ElonFreeman/Jaeger_robotic_arm/Documents/Techos.md

# 主从同步控制机械臂系统文档

## 

## 关键技术

RTOS、UART、SPI、关节位置传输协议、死区非线性滤波、有限状态机、硬件外部中断任务触发、任务间链式触发、空闲中断打印、夹持器边界抗堵转算法、初始零点校准与状态对齐、基于 GPIO 的实时任务性能分析、硬件微秒级延迟技术、内存块拷贝技术、基于时分复用数据流的状态机

## 远控机械臂控制系统技术架构栈

### 一、 物理与硬件传输层 (Hardware & Transport Layer)

- **UART & SPI 通信外设**：实现主控板与外部设备（上位机、总线舵机、主手传感器）的高速硬件级数据互联。

- **硬件微秒级延迟技术 (Microsecond Delay)**：基于定时器或时钟周期计数（DWT），实现总线舵机通信时序控制所需的微秒级精准等待。

- **硬件外部中断任务触发 (Exit Interrupt Trigger)**：利用引脚外部中断（EXTI），实现高优先级紧急信号或传感器边缘触发的瞬间响应。

- **空闲中断接收技术 (IDLE Interrupt)**：利用串口空闲中断，实现非固定长度数据包的按帧高效接收，降低 CPU 轮询开销。

### 二、 操作系统与调度层 (RTOS & Scheduling Layer)

- **FreeRTOS 多任务并发管理**：打破裸机阻塞限制，实现控制、通信、保护等多个任务的分时抢占式调度。

- **任务间链式触发技术 (Chained Task Triggering)**：利用信号量或事件标志组（Event Flags），实现“SPI接收完成 ➡️ 触发数据解析 ➡️ 触发电机控制”的一体化链式流水线调度。

- **基于 GPIO 的实时任务性能分析 (GPIO Profiling)**：利用空闲引脚的翻转电平配合**逻辑分析仪**，无侵入式地可视化分析 RTOS 的任务切换周期、执行功耗与抢占情况。

### 三、 数据处理与数据流管理层 (Data Processing & Routing Layer)

- **内存块拷贝技术 (memcpy)**：利用 C 语言标准库底层汇编优化的内存直接操作，实现 DMA 缓冲区到业务结构体的“零等待”高速数据转储。

- **关节位置传输协议设计**：自定义高效、紧凑的总线通信协议帧，解决多轴数据的序列化与反序列化。

- **基于时分复用数据流的状态机 (TDM Stream FSM)**：利用单一全局变量动态路由当前帧的关节 ID，实现单条总线上 6 轴关节数据的多路分时复用解析。

### 四、 核心控制与安全算法层 (Control & Safety Algorithm Layer)

- **初始零点校准与状态对齐技术 (Soft Start Alignment)**：利用上电初始状态机，抓取第一帧物理位置作为基准，通过一阶低通平滑过渡，彻底消除单片机通电瞬间机械臂“暴冲”的隐患。

- **死区非线性滤波算法 (Dead-band Filtering)**：有效拦截主手传感器的机械颤动与 ADC 随机噪声，解决电机高频啸叫与无效发热，延长总线舵机寿命。

- **夹持器边界抗堵转算法 (Anti-Rotor Lock)**：在缺少电流反馈的限制下，联合判定“目标-实际位置跟踪误差”与“实际物理速度”，通过时间累积消抖，在卡死瞬间触发“回退锁定”保护，防止烧毁末端舵机。
