ElonFreeman/Jaeger_robotic_arm/Documents/发票/1/3509128550dzfp_26332000004530192046_长江师范学院_20260..pdf

# 电子发票（普通发票） 发票号码： 开票日期：

购
买
方
信
息

统一社会信用代码/纳税人识别号：

销
售
方
信
息

统一社会信用代码/纳税人识别号：

名称： | 名称：
项目名称 | 规格型号 | 单 位 | 数 量 | 单 价 | 金 额 | 税率/征收率 | 税 额
合 | 计
价税合计（大写） | 贰佰玖拾陆圆伍角整 ¥296.50 （小写）

备 注

开票人：

26332000004530192046

2026年05月29日

长江师范学院

12500000709410568Y

杭州炟成科技有限公司

## 91330106MAK3QTP65E

¥293.56 | ¥2.94

汪梦葳

*电子元件*电子元器件* | 总线舵机-25KG | 件 | 5 58.7128712871287 | 293.56 | 1% | 2.94
