ElonFreeman/Jaeger_robotic_arm/Documents/发票/1/长江师范学院.pdf

# 电子发票（普通发票） 发票号码： 开票日期：

购
买
方
信
息

统一社会信用代码/纳税人识别号：

销
售
方
信
息

统一社会信用代码/纳税人识别号：

名称： | 名称：
项目名称 | 规格型号 | 单 位 | 数 量 | 单 价 | 金 额 | 税率/征收率 | 税 额
合 | 计
价税合计（大写） | 壹佰叁拾柒圆伍角整 ¥137.50 （小写）

备 注

开票人：

26952000002248763101

2026年05月30日

长江师范学院

12500000709410568Y

深圳市诺威芯电子有限公司

## 91440300MA5HDJ127G

¥136.14 | ¥1.36

陈伟杰

*集成电路*集成电路 STM32F407ZGT6
开发板
个 | 2 68.0693069306931 | 136.14 | 1% | 1.36
