ElonFreeman/Jaeger_robotic_arm/Documents/主从同步控制机械臂系统.docx

全国大学生物联网设计竞赛

# 主从同步控制机械臂系统

学校名称： | 长江师范学院
团队名称： | Shatterdome
队长： | 张浩
队员1： | 张译水
队员2： | 陈欣子洋
队员3： | 周思贤

全国大学生物联网设计竞赛组委会

2026年7月

# 设计作品名称

# 主从同步控制机械臂系统

# 摘要

针对核工业无接触作业、高压电力远控维修及毒害化工应急抢修等特种高危工业场景，全自动机器人因其难以应对复杂突发环境，使得主从同步控制系统机械臂成为保障作业人员安全、实现人机隔离的刚性技术需求。

针对上述工业实际需求，我们设计并实现了一种基于 FreeRTOS 实时操作系统的高实时性、高安全边界主从同步控制六自由度机械臂系统。本系统创新性地采用了双边对称主从控制架构，相比于传统的运动学映射系统，对称系统在主手拓扑结构与从手拓扑结构上具备高度的一致性与物理对称性。这种架构不仅消除了复杂的非线性空间坐标变换，从根本上降低了控制算法的运算开销与传动时延，还为操作人员提供了无与伦比的直观临场感与“手眼协同”操作体验，极大地提升了工业遥操作在救灾抢险与精细作业中的作业效率与控制精度，同时平缓了操作机械臂的学习曲线。

在硬件层面，系统采用多总线协同架构，主手端与从手端通过 SPI 协议通信，配合UART协议构建了高速、低延迟的数据桥梁；同时利用硬件外部中断（EXTI）与任务间链式触发技术（ITCT）实现高优先级紧急信号的瞬间响应与定长数据帧的高效收发。系统软件基于 FreeRTOS 进行抢占式多任务并发管理，引入事件标志组实现了“数据接收、动态解析、算法滤波、电机驱动、位置反馈”的链式流水线触发，并运用基于 GPIO 的实时任务性能分析技术（GPIO Profiling）完成了无侵入式的系统调度调测。

在核心算法层面，系统引入有限状态机（FSM）构建了初始零点校准与状态对齐技术，消除了工业现场上电瞬间机械臂“暴冲”的物理安全隐患；设计了死区非线性滤波算法，有效拦截主手传感器的机械颤动，攻克了从臂电机抖动等影响工业连续作业寿命的难题。此外，系统通过时分复用数据流状态机（TDM Stream FSM）在单条总线上实现了 6 轴关节数据的多路复用解析。实际运行与测试结果表明，该系统控制周期稳定，抗干扰能力强，在实现多轴高精度、高实时同步运动的同时，具备极强的边界安全防护能力。系统方案有效解决了工业遥操作中由于控制不当引发的设备损耗问题，在核工业无接触作业、高压电力维修、毒害化工环境操作等工业界实际场景中具有广阔的落地与应用前景。

关键词：物联网、双边对称主从控制架构、FreeRTOS任务调度、有限状态机、抗堵转算法、死区滤波

目 录

# 第1章 设计需求分析

## 1.1需求分析

在当前工业生产实践中，常常出现危险复杂的工况，如核泄漏、毒害物质泄露、高温高压等，在这种情况下，经常需要人工实时介入，但是不可能由人员直接进入作业；在这些危险复杂的场景下，工人们需要一种操作简单直观且灵巧的机械臂辅助作业，以提升工作效率，减少人员直接进入带来的人身安全风险。当前普遍应用的工业机械臂，大多使用摇杆操控或者需要事先编程才能执行固定动作，在分秒必争、瞬息万变的危险复杂工况下很明显是不够灵活的。

### 1.2研究目的

本研究创新性地采用一种新型的双边对称主从控制架构，这种架构组建一个拓扑对称系统，相比于传统的运动学解算映射架构，由操作人员控制的主臂和执行作业的从臂在拓扑结构上高度对称，主臂将关节位置映射到从臂对应关节上，从而实现动作；这种架构使得操作机械臂变得极为简单直观，操作人员用主臂做出特定的动作，从臂会实时做出相同的动作。本研究旨在提供一种操作更简单直观、更灵活的机械臂控制架构以满足工业界生产需求。

### 1.3行业研究现状

基于双边对称主从控制架构的机械臂目前尚未在工业界获得大规模应用，目前主要存在于学科竞赛以及开源项目研究中，尚属于前沿研究领域。

# 第2章 特色与创新

## 2.1双边对称主从控制架构

我们采用了一种创新的控制架构，这种架构不同于传统的摇杆或示教器操作，主臂和从臂的拓扑结构呈现高度对称状态，主臂从臂均采用可回读位置的总线舵机，主臂上的总线舵机充当位置传感器，负责位置采样，通过主机将各个关节的实时位置编制成数据帧，发送给从机；从机解析这些数据帧，生成作动指令发送给对应的关节，从而使从臂的各个关节映射主臂的关节姿态。这种架构的设计灵感来源于科幻电影《环太平洋》中驾驶员和机甲的交互逻辑：驾驶员在驾驶舱中通过肢体运动改变相应支架的姿态，机甲的肢体在外部做出相同的动作。

## 2.2基于FreeRTOS的高实时性链式任务调度

为了便于管理系统的操作时序，我们在FreeRTOS中设置了两个任务：作动任务与位置反馈任务。其中，作动任务负责接收主机发送的数据帧并解析数据帧，生成作动指令发往从臂，优先级较高；反馈任务负责向从臂各个关节发送位置回读指令，接收回读数据并打印到串口，优先级较低。

## 2.2.1基于硬件外部中断触发的高优先级任务调度

为了保证主从机同步通信，我们采用了串行外部设备接口（SPI）协议实现主从机之间的通信，SPI协议具有MISO、MOSI两根数据线，时钟线，使能线；我们采用软件使能方法，将主机指定引脚设为使能引脚，并将从机使能引脚设置为外部中断模式，主机启动传输时使能引脚改变从机对应引脚电平，以此触发FreeRTOS中的最高优先级的作动任务的执行。

## 2.2.2任务间链式触发调度

作动任务执行完成后，启动从臂关节位置反馈任务，我们采用了基于事件标志组的任务间链式触发调度技术，作动任务在结束时改变关节位置反馈任务的线程标志位，以启动其执行。

## 2.3基于高速内存块拷贝的多总线协同技术

我们在系统中采用了两种通信协议，通用异步收发（UART）、串行外设接口（SPI），在两种协议之间转换时需要拷贝内存块；我们摒弃了传统的基于循环的单字节拷贝，转而采用memcpy函数进行整块内存拷贝，将拷贝操作从线性时间降为常数时间，大大提高了拷贝速度，提升了系统的通信实时性。

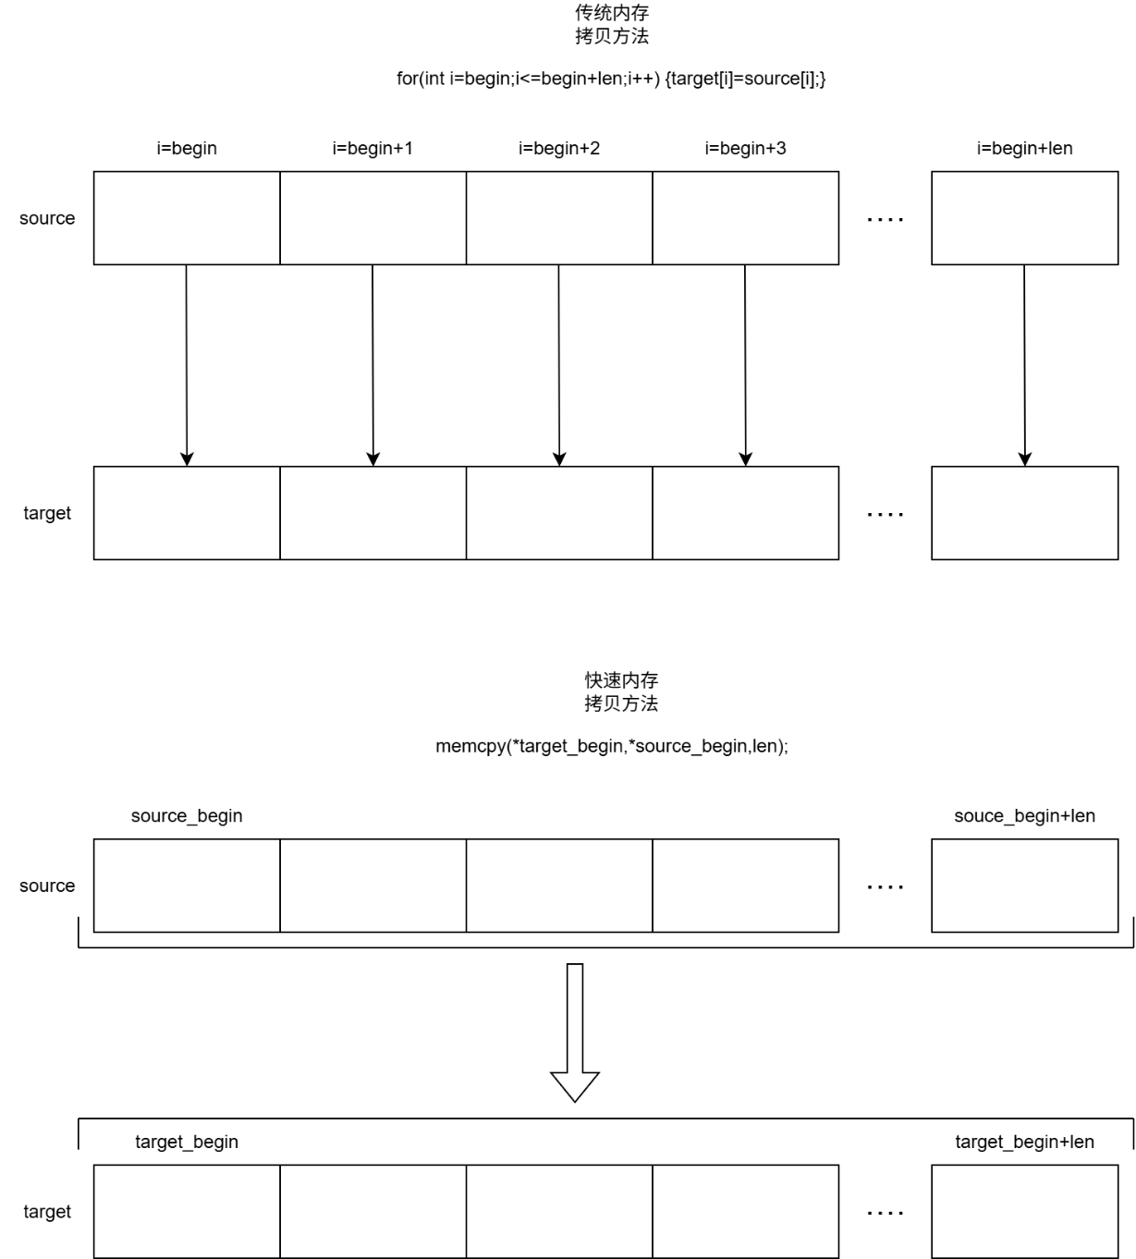
[picture p35: figure]

## 2.4基于有限状态机的初始状态对齐与死区非线性滤波

在研究中，我们发现主臂舵机的回读采样存在误差，这会导致从臂对应舵机产生抖动。为此，我们引入了死区非线性滤波技术，通过将历史位置与指令位置作差，如果小于一定阈值，则拒绝执行指令。但是，这种方法引入了一个新问题，系统刚上电时是没有历史位置的，我们引入有限状态机进行初始状态对齐，在上电后的第一个指令周期内采样到的各个关节数据将被作为初始历史位置，在此期间，收到的数据帧只做记录，不产生作动指令。

## 2.5基于时分复用的关节位置数据传输协议

由于总线舵机返回位置接收到的字符串中有大量无关紧要的内容，为了提高系统的通信实时性，我们创建了一种通信协议，协议数据帧中包含关节地址以及作动位置；主机采样收到主臂返回的采样值时，提取其中的关节地址以及位置，生成一个五字节的数据帧，发往从机，从机收到后解析数据帧，生成作动指令，然后向从臂发送作动指令。由于协议的数据帧很简短，所以传输效率很高，系统通信实时性得到了明显提高。

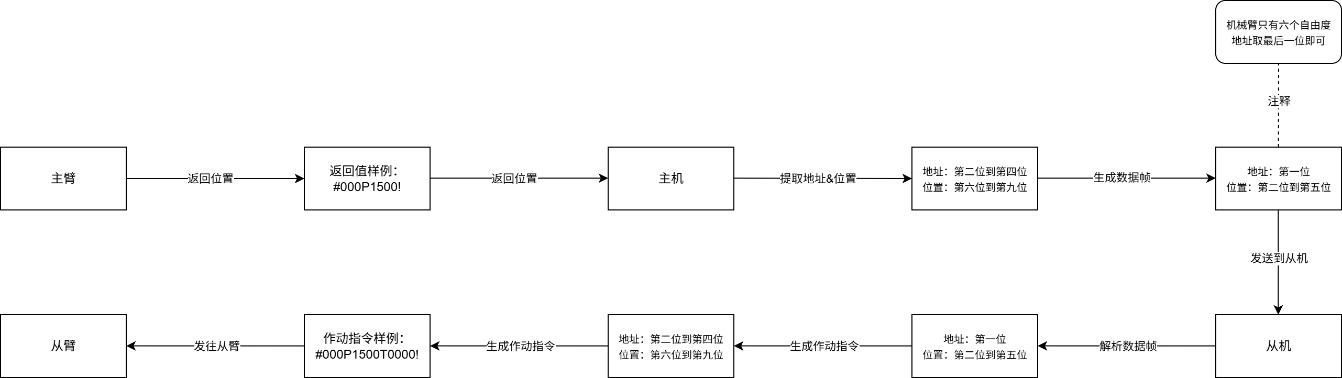
[picture p36: figure]
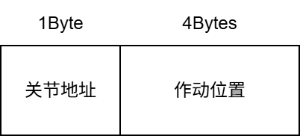
[picture p37: figure]

## 2.6基于 GPIO 的实时任务性能分析

我们指定部分引脚为任务调度指示器，通过改变电平指示不同任务的调度状态，在逻辑分析仪的采样图谱上可以通过这些引脚的高低电平状态直观地了解任务的调度状态以及时序，并分析系统信号完整性；这对故障排除以及时序优化非常有帮助。

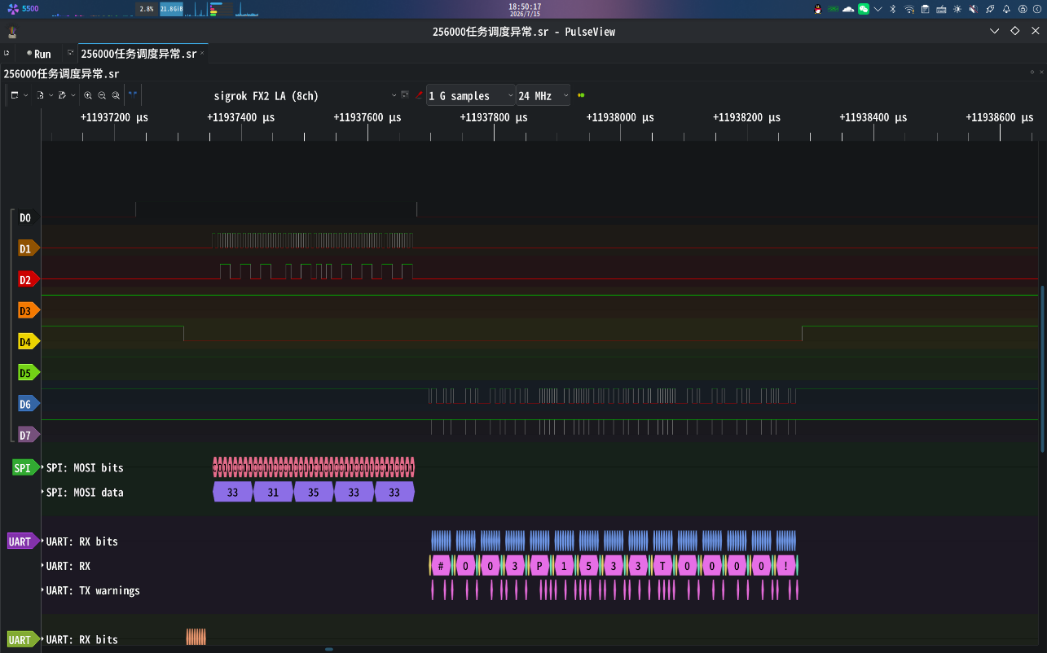
[picture p38: figure]

## 2.7硬件微秒级精密延迟技术

在时序调试的过程中，我们发现，由于任务调度响应速度以及采样时序的问题，从机开始接收数据帧和主机开始发送数据帧两个动作不能精确地同步，这会使得从机错过数据帧的第一个字节，从而导致指令错乱。为此，我们引入了基于数据观察点与追踪单元（Data Watchpoint and Trace,DWT）中周期计数器（CYCCNT）的微秒级延迟技术，SPI使能触发后，将主机发送数据帧操作向后推迟20微秒，等到从机的作动任务调度就绪后再开始发送，既保证了信号完整性，又不破坏通信实时性。

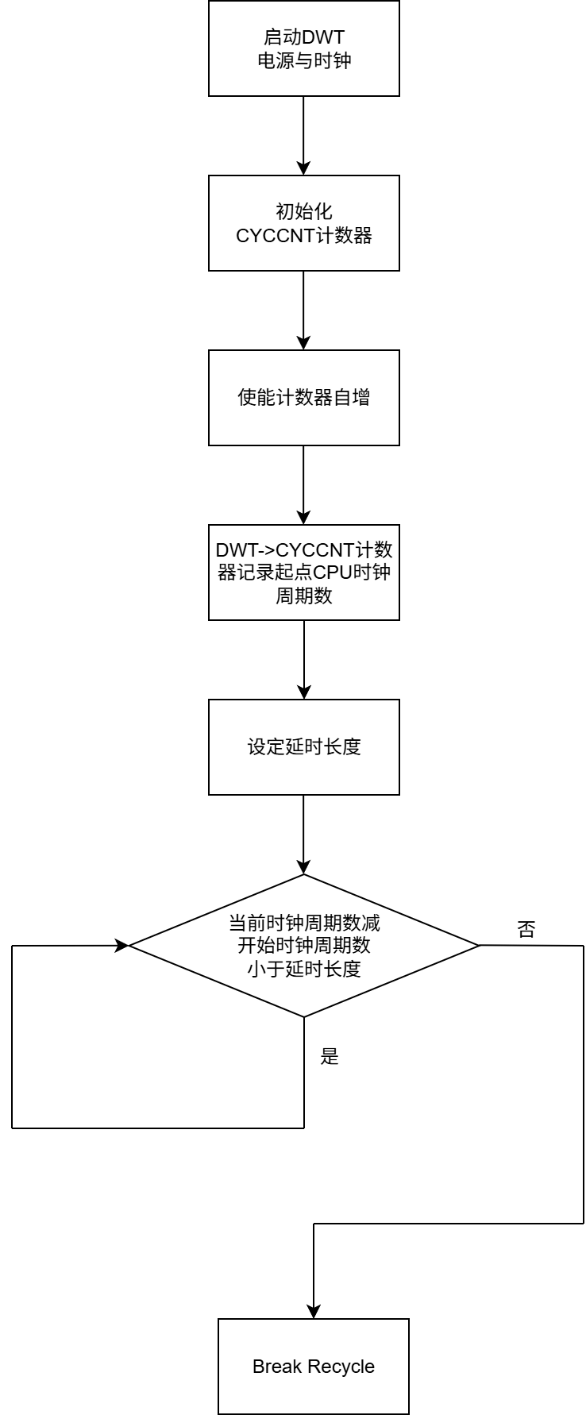
[picture p39: figure]

# 第3章 功能设计

### 3.1 拓扑对称的主从姿态实时同步功能

### 3.1.1功能描述

我们构建了物理结构与算法通道对称的双端硬件拓扑结构。主手端总线舵机充当角度传感器，实时采集关节的动作姿态；通过高速总线将多轴角度数据透传至从手端，驱动从手舵机做出响应。

### 3.1.2主要作用

该方法彻底规避了传统控制架构中极度耗费算力的逆运动学矩阵解算，实现了控制算法的低开销与毫秒级物理同步。同时为操作人员提供了直观的“手眼协同”与“所见即所得”临场感，大幅降低了复杂工况下的误操作率。

### 3.2基于 FreeRTOS 的事件驱动型高实时调度功能

### 3.2.1功能描述

从机软件内核采用 FreeRTOS 实时操作系统，规划了作动任务与位置反馈任务多任务并发架构。利用硬件外部中断（EXTI）接收高优先级任务调度信号，并采用轻量级线程标志位（Thread Flags）实现任务间的链式调度。

### 3.2.2主要功能

解决了传统裸机轮询机制带来的前向阻塞与控制周期漂移问题，保证了主从机数据交互同步进行，保证了信号完整性，提升了通信实时性。

### 3.3多总线协同与数据流水线路由功能

### 3.3.1功能描述

系统整合了 SPI 高速同步总线、UART串行舵机总线及 USB 串口等异构总线。硬件上通过 SPI+UART 实现板级数据的零等待转储；软件上自定义了基于时分复用（TDM）的传输协议，利用全局状态变量在单条总线上实现 6 轴关节数据的动态分时解析与路由。

### 3.3.2主要功能

极大地精简了机械臂复杂的物理布线拓扑，克服了多轴数据流并发导致指令错乱的隐患。以极低的硬件带宽与接口成本，解决了不同速率总线之间的数据吞吐瓶颈与通信拥堵。

### 3.4初始零点对齐与抗抖动滤波功能

### 3.4.1功能描述

在控制信号链路中集成了基于有限状态机（FSM）的软启动对齐算法与死区非线性滤波算法。系统上电时强制锁定初始安全点；在正常运行态下，对历史位置位置与当前指令位置作差，若差值小于设定阈值，则拦截当前作动指令，从而消除电机抖动。

### 3.4.2主要功能

解决了工业现场系统刚通电瞬间由于主从位置不一致引发的机械“暴冲”伤人隐患；同时有效过滤了主手传感器的采样噪声，攻克了影响电机作业寿命的电机抖动问题。

### 3.5无电流反馈的夹具边界抗堵转防护功能

### 3.5.1功能描述

针对系统选用的总线舵机缺少电流/扭矩实时反馈接口的限制，在控制层设计了针对末端夹具物理极值的运动范围截断算法，拦截越界的非法指令，避免电机在夹具到达物理位置极限后堵转烧毁。

### 3.5.2主要作用

在不增加额外物理电流传感器成本的前提下，建立了软件边界安全屏障。在到达物理极值点前拦截越界指令，避免电机堵转烧毁，提高了设备生存能力。

### 3.6从机回读从臂关节实际位置功能

### 3.6.1功能描述

从机结束作动任务后通过轻量级线程标志位触发从臂关节位置反馈任务调度，回读作动后关节的实际位置。

### 3.6.2主要作用

对比主臂发出的作动指令值与从臂运动后实际值，帮助开发者评估系统误差并监测系统状态。

# 第4章 系统实现

## 4.1系统总体架构

系统采用总线舵机组成主臂和从臂，主臂作为姿态采样网络，主臂的姿态采样与采样数据处理由主机MCU进行，主机MCU将处理后的采样数据发送给从机，从机根据采样数据生成作动指令，并向从臂发送作动指令，然后接收从臂位置反馈数据。主机采用队列的方式按顺序读取主臂每个关节的位置并发送对应的数据帧。主从机MCU均采用STM32F407ZGT6开发板。

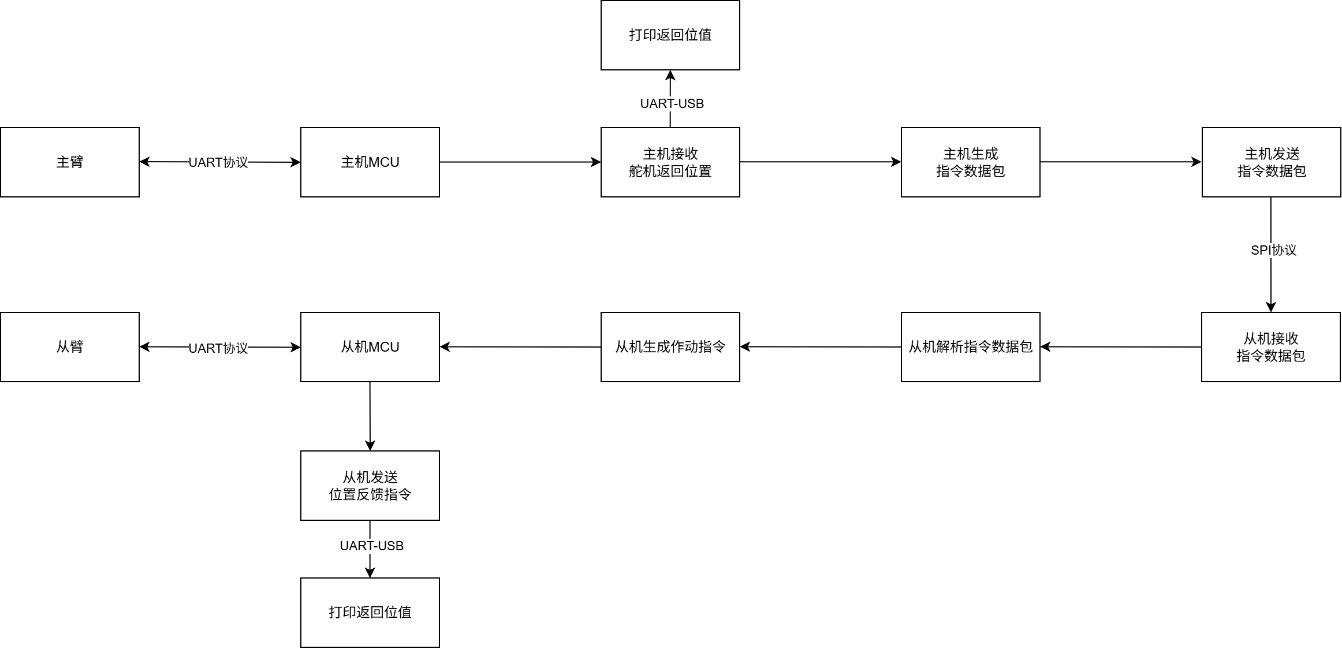
[picture p40: figure]

## 4.2传感层

传感层采用六个总线舵机组成基于协议的UART总线传感网络，由主机MCU轮询发送读取当前位置的指令，然后接收总线舵机返回的值。

## 4.3传输层

主机MCU接收到总线舵机返回的位置数据时，提取其中的关节地址与位置，生成一个由五个字节组成的数据包，通过SPI协议发送到从机MCU，其中主机的SPI片选使能采用的是软件方法，即通过手动拉高和拉低主机MCU上指定的片选引脚电平实现触发从机MCU接收SPI通路上的数据包，保证主机发送和从机接收的动作同步进行。从机接收到主机发来的数据包后，从中提取到关节地址和对应的位置。

## 4.4控制层

从机MCU从数据包中提取到关节地址与对应的位置后，根据这些信息生成作动指令，通过UART总线网络发送到指定关节上执行作动；紧接着，从机MCU发送读取位置指令，读取从臂关节位置，实现位置反馈。

我们将接收解析并发送作动指令以及反馈关节实际位置的操作分解到两个FreeRTOS任务中进行，采用硬件外部中断以及任务间链式触发技术管理任务调度；其中，作动任务为高优先级任务，为其配置了硬件外部中断引脚，该引脚与主机的SPI片选使能引脚相连，当主机的SPI片选引脚发送片选信号时，该外部中断引脚电平被拉低，此时作动任务被触发，从机启动SPI接收，然后生成作动指令并发送。作动任务结束时，会设置一个进程标志位osThreadFlags，触发位置反馈任务的执行。位置反馈任务完成后，系统进入下一个任务调度周期。

## 4.5开发与调试技术

## 4.5.1开发环境

操作系统：Fedora Linux 44

程序设计环境：Microsoft VS Code + STM32CubeIDE for Visual Studio Code plugin

编译器：arm-none-eabi-gcc (GNU Arm Embedded Toolchain 10.3-2021.10)
烧录调试器：DAPLink + OpenOCD 0.12.0

引脚定义与初始化代码生成：STM32CubeMX 6.18.0

## 4.5.2基于GPIO的实时任务性能分析

为了观测调试系统操作时序与任务调度，我们使用了基于GPIO的实时任务性能分析技术。我们为每个任务配置了任务调度状态指示引脚，在任务开始时拉低对应引脚的电平，任务结束时恢复对应引脚的电平，用逻辑分析仪连接这些指示引脚，我们就可以在逻辑分析仪上位机软件Pulseview上直观地了解到任务调度状况以及操作时序，监测每个操作的时间占用情况，也可以通过Pulseview内置解码器分析各个信号通路上的信号完整性。

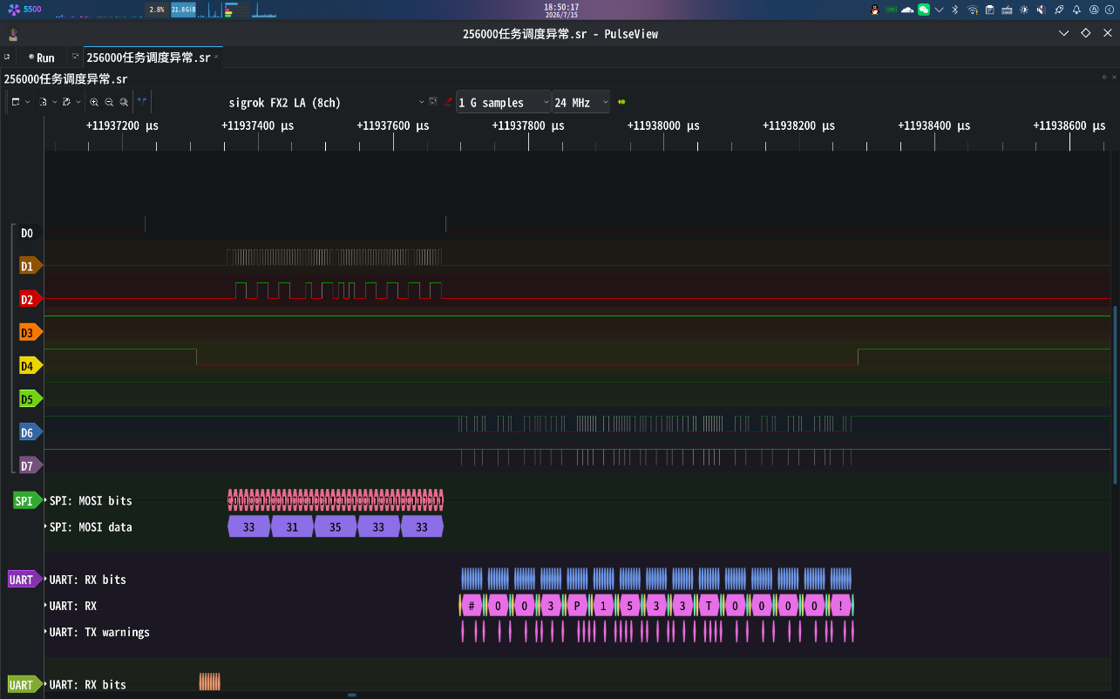
[picture p41: figure]

# 第5章 其他内容

## 5.1元件介绍

## 5.1.1总线舵机

众灵科技ZP25S、ZP25D型总线舵机

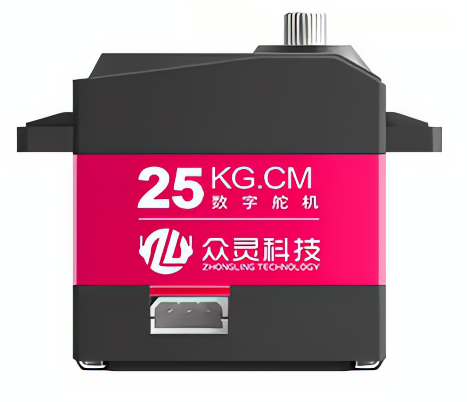
[picture p42: figure]
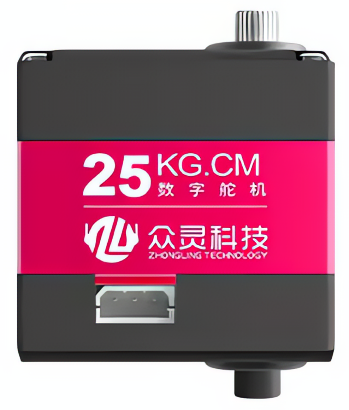
[picture p43: figure]

## 5.1.2主从机MCU

STM32F407ZGT6开发板

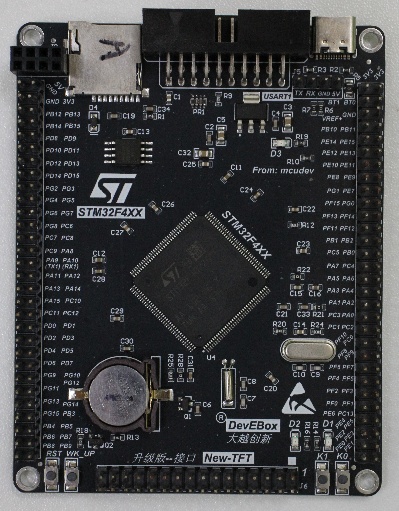
[picture p44: figure]
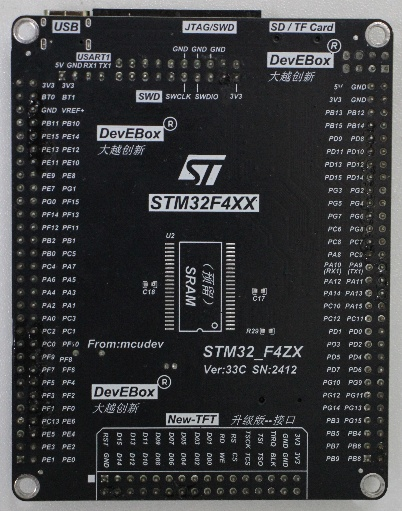
[picture p45: figure]

## 5.1.3舵机驱动器

ZLink总线舵机驱动模块

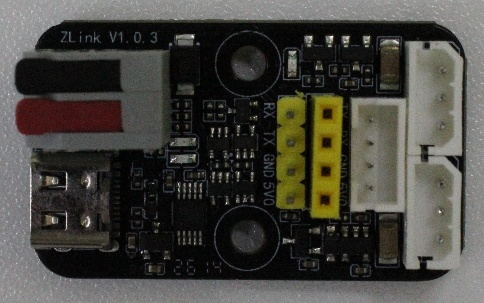
[picture p46: figure]

## 5.1.4烧录调试器

DAPLink

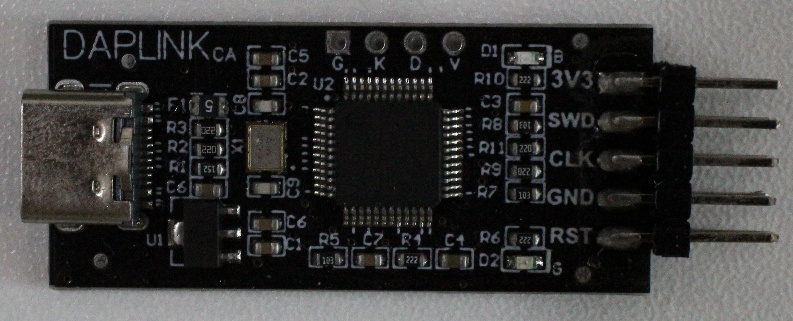
[picture p47: figure]

## 5.1.5逻辑分析仪

nanoDLA 8-channel

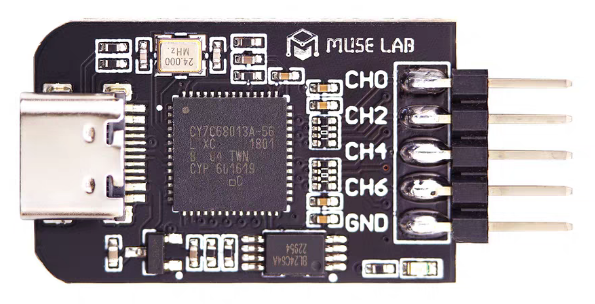
[picture p48: figure]
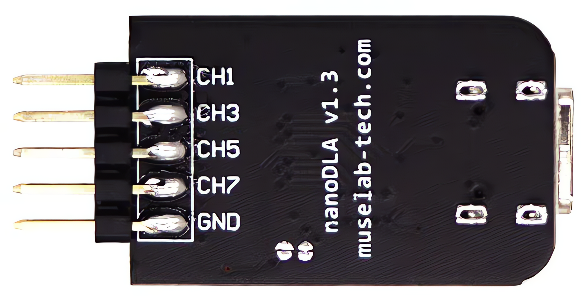
[picture p49: figure]

## 5.1.6直流稳压电源

迈胜MN-3010F

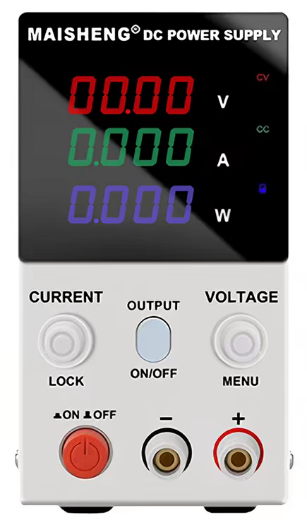
[picture p50: figure]

## 5.1.7结构组件

铝合金喷砂钣金结构组件，铝合金CNC舵盘

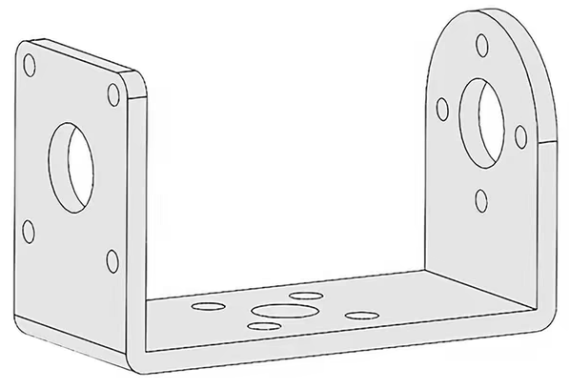
[picture p51: figure]
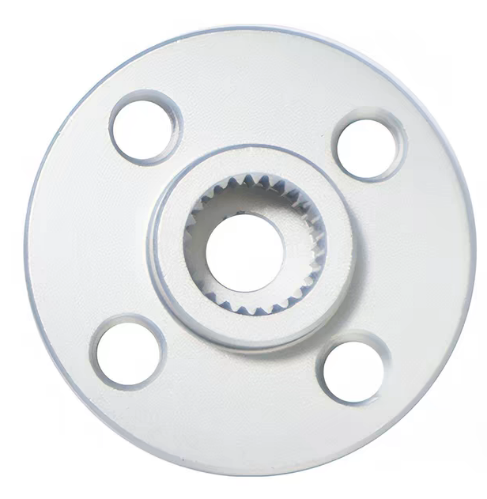
[picture p52: figure]

## 5.2系统缺陷

## 5.2.1夹持时抗堵转

从臂顶端夹具在触碰到物体时应停止动作保持位置，若继续施力则可能导致堵转过流烧毁。本研究中使用的总线舵机不具备监测电流的功能，事实上，市面上能采购到的总线舵机绝大多数都不具有监测电流的功能。我们曾尝试使用现场反馈夹具舵机位置与作动指令比较的方法，但是由于舵机响应速度的问题，这会打乱任务调度时序，破坏信号完整性，所以我们放弃了这种方法；目前的解决方法是操作时密切观察夹具与物体的接触状态，夹具接触物体后立即停止施力。目前尚未找到一种合适的夹持时抗堵转机制。

## 5.2.2由总线舵机精度缺陷导致的抖动

正如前文所述，我们引入了死区非线性滤波算法，但是在实际测试中我们仍然监测到了总线舵机的微小抖动，我们判断这是由于硬件固有精度不足造成的，目前尚未找到合适的解决方法。

## 5.3成本核算

名称 | 数量/个 | 单价/RMB | 总价/RMB
总线舵机25KG | 10 | 74.25/59.3 | 667.75
总线舵机10KG | 2 | 26.73 | 53.46
开发板 | 2 | 68.75 | 137.5
结构组件 | 17 | 2.63/3.38 | 42.49
舵盘 | 18 | 1.7 | 34.6
舵机驱动板 | 2 | 22.5 | 45
烧录调试器 | 2 | 9.72 | 19.44
逻辑分析仪 | 1 | 31 | 31
直流稳压电源 | 1 | 151.3 | 151.3
合计 | | | 1182.54

## 5.4 GitHub项目地址

https://github.com/ElonFreeman/Jaeger_robotic_arm

全国大学生物联网设计竞赛设计文档[作品名称]
