ElonFreeman/Jaeger_robotic_arm/Documents/发票/1/3510834733dzfp_26952000002279634511_长江师范学院_20260..pdf

# 电子发票（普通发票） 发票号码： 开票日期：

购
买
方
信
息

统一社会信用代码/纳税人识别号：

销
售
方
信
息

统一社会信用代码/纳税人识别号：

名称： | 名称：
项目名称 | 规格型号 | 单 位 | 数 量 | 单 价 | 金 额 | 税率/征收率 | 税 额
合 | 计
价税合计（大写） | 叁圆捌角柒分 ¥3.87 （小写）

备 注

开票人：

26952000002279634511

2026年06月01日

长江师范学院

12500000709410568Y

深圳市盈临科技有限公司

## 91440300MAEXXNCU78

¥3.83 | ¥0.04

刘福明

*电线电缆*数据线 | 长度:0.5m;颜色
分类:Type-c 白
色/数据+充电
条 | 1 3.8316831683168 | 3.83 | 1% | 0.04
