ElonFreeman/Jaeger_robotic_arm/Documents/发票/1/dzfp_26332000004575038326_杭州松甲科技有限公司_20260530170806.pdf

# 电子发票（普通发票） 发票号码： 开票日期：

购
买
方
信
息

统一社会信用代码/纳税人识别号：

销
售
方
信
息

统一社会信用代码/纳税人识别号：

名称： | 名称：
项目名称 | 规格型号 | 单 位 | 数 量 | 单 价 | 金 额 | 税率/征收率 | 税 额
合 | 计
价税合计（大写） | 陆圆肆角叁分 ¥6.43 （小写）
备 注 | 销方开户银行:杭州银行股份有限公司余杭宝塔支行; 银行账号:3301041060000278006

开票人：

26332000004575038326

2026年05月30日

长江师范学院

12500000709410568Y

杭州松甲科技有限公司

## 91330110MAD7WAWW4P

¥6.37 | ¥0.06

任天一

*电子元件*机器人支架 | Robot bracket | 件 | 1 6.3663366336634 | 6.37 | 1% | 0.06
