ElonFreeman/Jaeger_robotic_arm/Documents/发票/1/dzfp_26332000004610146321_杭州星呗科技有限公司_20260602164..pdf

# 电子发票（普通发票） 发票号码： 开票日期：

购
买
方
信
息

统一社会信用代码/纳税人识别号：

销
售
方
信
息

统一社会信用代码/纳税人识别号：

名称： | 名称：
项目名称 | 规格型号 | 单 位 | 数 量 | 单 价 | 金 额 | 税率/征收率 | 税 额
合 | 计
价税合计（大写） | 叁拾肆圆陆角整 ¥34.60 （小写）
备 注 | 收款人:薛润瑜; 复核人:大雪梨

开票人：

26332000004610146321

2026年06月01日

长江师范学院

12500000709410568Y

杭州星呗科技有限公司

## 91330110MA2J2Y1Y66

¥34.26 | ¥0.34

杨雪丽

*机器人*金属舵盘 | DP-1 | 件 | 18 1.9031903190319 | 34.26 | 1% | 0.34
