ElonFreeman/Jaeger_robotic_arm/Documents/发票/1/dzfp_26952000002242316296_深圳市宝安区松岗街道智睿贸易商行_20260529233118.pdf

# 电子发票（普通发票） 发票号码： 开票日期：

购
买
方
信
息

统一社会信用代码/纳税人识别号：

销
售
方
信
息

统一社会信用代码/纳税人识别号：

名称： | 名称：
项目名称 | 规格型号 | 单 位 | 数 量 | 单 价 | 金 额 | 税率/征收率 | 税 额
合 | 计
价税合计（大写） | 伍拾贰圆伍角玖分 ¥52.59 （小写）
备 注 | 购方开户银行:-; 银行账号:-; 收款人:林良冰; 复核人:林小珍

开票人：

26952000002242316296

2026年05月29日

长江师范学院

12500000709410568Y

深圳市宝安区松岗街道智睿贸易商行

## 92440300MA5F6ULE2U

¥52.07 | ¥0.52

林良冰

*电子元件*电子元器件
舵机配件支架
支架 | 个 | 4 13.0173267326733 | 52.07 | 1% | 0.52
