ElonFreeman/Jaeger_robotic_arm/Documents/发票/1/dzfp_26952000002246682961_深圳市创电未来电子有限公司_20260530151852.pdf

# 电子发票（普通发票） 发票号码： 开票日期：

购
买
方
信
息

统一社会信用代码/纳税人识别号：

销
售
方
信
息

统一社会信用代码/纳税人识别号：

名称： | 名称：
项目名称 | 规格型号 | 单 位 | 数 量 | 单 价 | 金 额 | 税率/征收率 | 税 额
合 | 计
价税合计（大写） | 壹拾壹圆陆角整 ¥11.60 （小写）

备 注

开票人：

26952000002246682961

2026年05月30日

长江师范学院

12500000709410568Y

深圳市创电未来电子有限公司

## 91440300MAK0GYWJ2K

¥11.49 | ¥0.11

陈勇彬

*电子元件*电子元器件 | 1 11.4851485148515 | 11.49 | 1% | 0.11
