ElonFreeman/Jaeger_robotic_arm/Documents/发票/2/3532410712681455281378361344.pdf

# 电子发票（普通发票） 发票号码： 开票日期：

购
买
方
信
息

统一社会信用代码/纳税人识别号：

销
售
方
信
息

统一社会信用代码/纳税人识别号：

名称： | 名称：
项目名称 | 规格型号 | 单 位 | 数 量 | 单 价 | 金 额 | 税率/征收率 | 税 额
合 | 计
价税合计（大写） | 贰拾壹圆肆角柒分 ¥21.47 （小写）

备 注

开票人：

26332000005041049221

2026年06月14日

长江师范学院

12500000709410568Y

金华爱慕斯优科技有限公司

## 91330703MACCET0A78

¥19.00 | ¥2.47

王雪微

*电子元件*电子元器件 | 个 | 6 3.1666666666372 | 19.00 | 13% | 2.47
