ElonFreeman/Jaeger_robotic_arm/Documents/发票/2/_26442000006699610981.pdf

# 电子发票（普通发票） 发票号码： 开票日期：

购
买
方
信
息

统一社会信用代码/纳税人识别号：

销
售
方
信
息

统一社会信用代码/纳税人识别号：

名称： | 名称：
项目名称 | 规格型号 | 单 位 | 数 量 | 单 价 | 金 额 | 税率/征收率 | 税 额
合 | 计
价税合计（大写） | 壹佰伍拾壹圆叁角整 ¥151.30 （小写）

备 注

开票人：

26442000006699610981

2026年06月15日

长江师范学院

12500000709410568Y

惠州市惠阳区淡水颢鼎五金经营部

## 92441381MA7GCM0Y86

¥149.80 | ¥1.50

邹平周

*变压器整流器*可调直流
稳压电源
MN3010F | 台 | 1 149.80198019802 | 149.80 | 1% | 1.50
