ElonFreeman/Jaeger_robotic_arm/Documents/发票/2/_26952000002517722746.pdf

# 电子发票（普通发票） 发票号码： 开票日期：

购
买
方
信
息

统一社会信用代码/纳税人识别号：

销
售
方
信
息

统一社会信用代码/纳税人识别号：

名称： | 名称：
项目名称 | 规格型号 | 单 位 | 数 量 | 单 价 | 金 额 | 税率/征收率 | 税 额
合 | 计
价税合计（大写） | 伍拾伍圆整 ¥55.00 （小写）

备 注

开票人：

26952000002517722746

2026年06月16日

长江师范学院

1 2 5 0 0 0 0 0 7 0 9 4 1 0 5 6 8Y

深圳市驿生胜利科技有限公司

9 1 4 4 030 0 0 638 8 930 2 8

¥48.67 | ¥6.33

刘清

*其他仪器仪表机械*数字
万用表
VICTOR 9205C | 台 | 1 48.6725663716814 | 48.67 | 13% | 6.33
