ElonFreeman/Jaeger_robotic_arm/Documents/发票/2/dzfp_26952000002486016541_长江师范学院_20260615100328.pdf

# 电子发票（普通发票） 发票号码： 开票日期：

购
买
方
信
息

统一社会信用代码/纳税人识别号：

销
售
方
信
息

统一社会信用代码/纳税人识别号：

名称： | 名称：
项目名称 | 规格型号 | 单 位 | 数 量 | 单 价 | 金 额 | 税率/征收率 | 税 额
合 | 计
价税合计（大写） | 陆佰柒拾玖圆整 ¥679.00 （小写）

备 注

开票人：

26952000002486016541

2026年06月15日

长江师范学院

12500000709410568Y

深圳市汇盛微电子有限公司

## 91440300MA5H7EWG2D

¥672.28 | ¥6.72

黄鹤飞

*电工仪器仪表*示波器 1014D标配英文
版
套 | 1 672.277227722772 | 672.28 | 1% | 6.72
