ElonFreeman/Jaeger_robotic_arm/Documents/pics/屏幕截图_20260715_185031.png

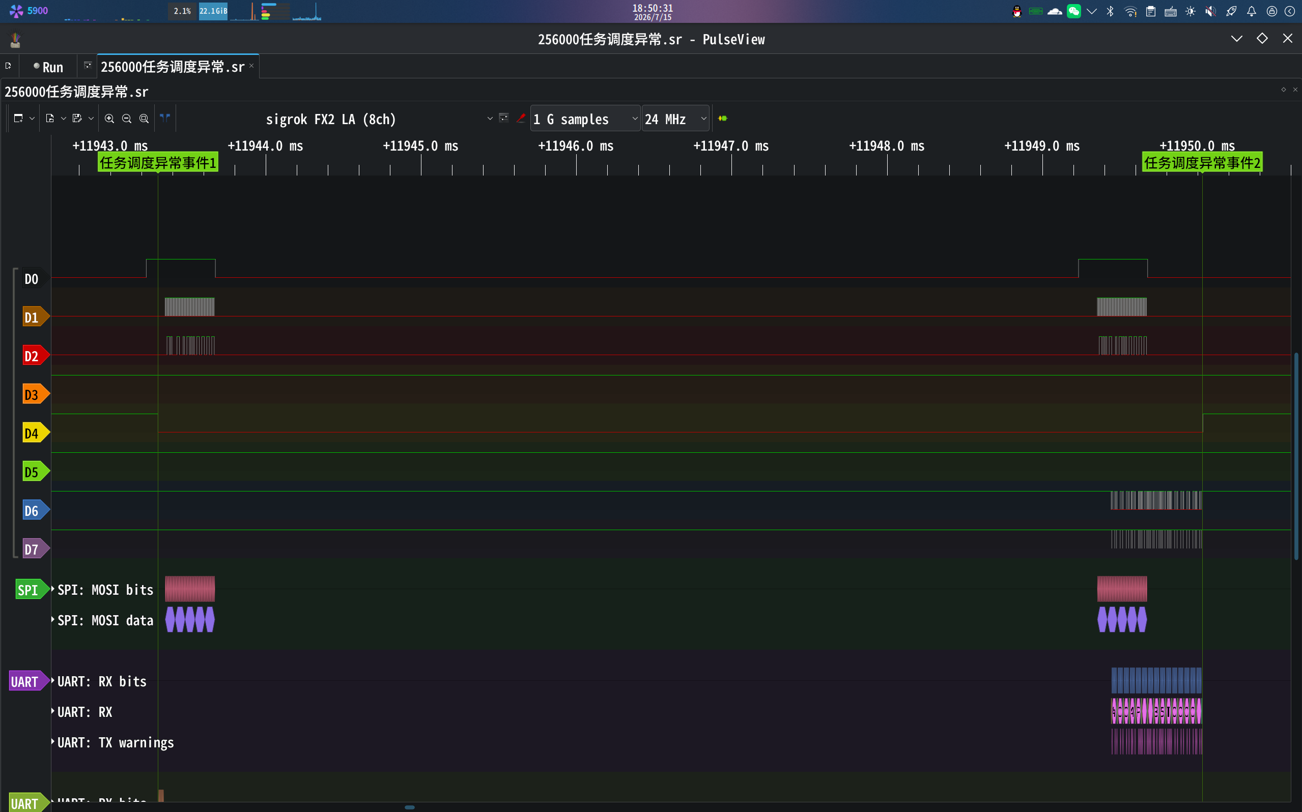
Documents/pics/屏幕截图_20260715_185031.png
