ElonFreeman/Jaeger_robotic_arm/Documents/pics/屏幕截图_20260715_185048.png

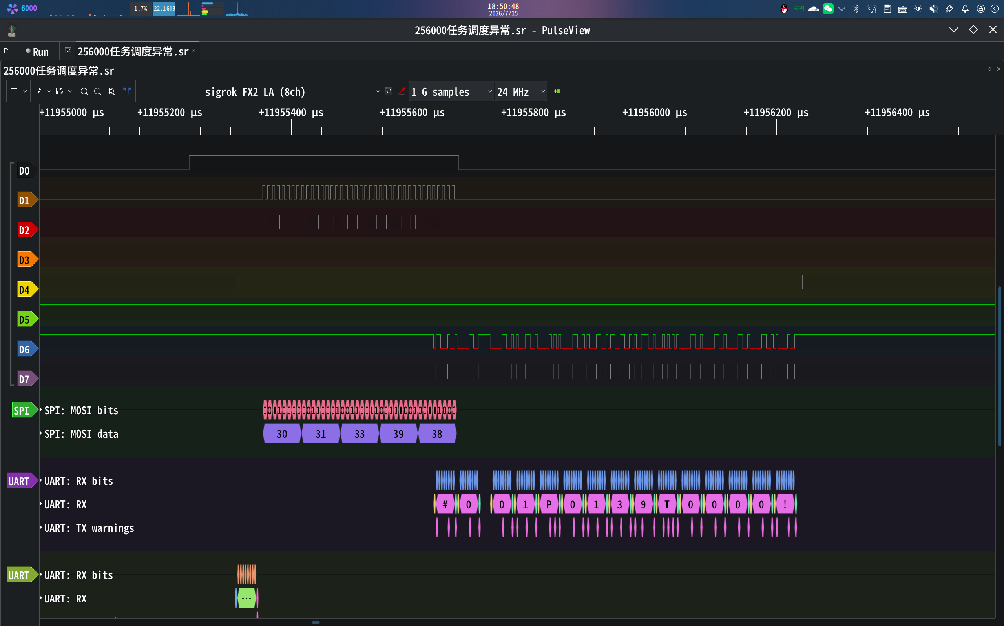
Documents/pics/屏幕截图_20260715_185048.png
