ElonFreeman/Jaeger_robotic_arm/Documents/发票/1/1780126242569.jpg

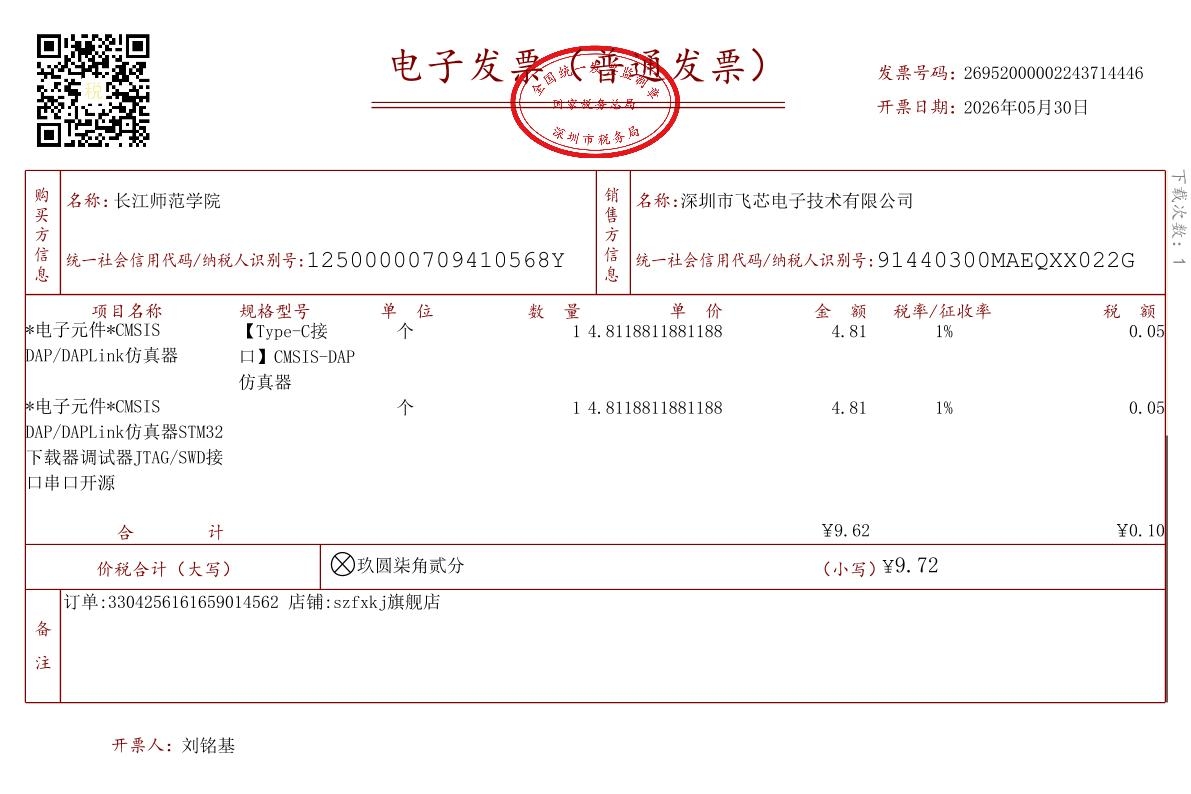
Documents/发票/1/1780126242569.jpg
