ElonFreeman/Jaeger_robotic_arm/master/Core/Src/main.c

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
/* Includes ------------------------------------------------------------------*/
#include "main.h"

/* USER CODE BEGIN Includes */
#include "stdio.h"
#include "string.h"
/* USER CODE END Includes */

SPI_HandleTypeDef hspi3;

UART_HandleTypeDef huart4;
UART_HandleTypeDef huart1;

/* USER CODE BEGIN PV */
char release_torque[9]="#255PULK!";
char command_get_position[9]="#000PRAD!";
char receive_position[11]="";
char transmit_position[5]="";
//char command_temp_volt[9]="";
/* USER CODE END PV */

void SystemClock_Config(void);
static void MX_GPIO_Init(void);
static void MX_UART4_Init(void);
static void MX_USART1_UART_Init(void);
static void MX_SPI3_Init(void);
/* USER CODE BEGIN PFP */

//初始化DWT的电源和时钟，并启动计数器
void DWT_Delay_Init(void)
{
    CoreDebug->DEMCR |= CoreDebug_DEMCR_TRCENA_Msk;  //开启内核跟踪调试组件（TRCENA）的使能
    DWT->CYCCNT = 0;  //将周期计数器 CYCCNT 清零
    DWT->CTRL |= DWT_CTRL_CYCCNTENA_Msk;  //使能 CYCCNT 计数器，使其开始自增
}

// 纯硬件微秒延时函数
void delay_us(uint32_t us)
{
    uint32_t startTick = DWT->CYCCNT;  //CPU周期当前计数值
    // 根据主频计算需要的时钟周期数
    uint32_t delayTicks = us * (SystemCoreClock / 1000000);  //预设延时长度：需要经过的总时钟周期数

    while ((DWT->CYCCNT - startTick) < delayTicks);  //阻塞等待，直到经过的时钟周期数达到了目标值
}
/* USER CODE END PFP */

/**
  * @brief  The application entry point.
  * @retval int
  */
int main(void)
{

  /* MCU Configuration--------------------------------------------------------*/

  /* Reset of all peripherals, Initializes the Flash interface and the Systick. */
  HAL_Init();

  /* Configure the system clock */
  SystemClock_Config();

  /* USER CODE BEGIN SysInit */
  DWT_Delay_Init();
  /* USER CODE END SysInit */

  /* Initialize all configured peripherals */
  MX_GPIO_Init();
  MX_UART4_Init();
  MX_USART1_UART_Init();
  MX_SPI3_Init();
  /* USER CODE BEGIN 2 */
  HAL_UART_Transmit(&huart4,(uint8_t*)release_torque,sizeof(release_torque),1);
  /* USER CODE END 2 */

  /* Infinite loop */
  /* USER CODE BEGIN WHILE */
  while (1)
  {
    for(uint8_t i=0;i<6;i++)
    {
      command_get_position[3]=i+'0'; transmit_position[0]=i+'0';
      HAL_UART_Transmit(&huart4,(uint8_t*)command_get_position,sizeof(command_get_position),1);
      HAL_UART_Receive(&huart4,(uint8_t*)receive_position,sizeof(receive_position),4);
      //for(uint8_t i=1,j=5;i<5;i++,j++) {transmit_position[i]=receive_position[j];}
      memcpy(&transmit_position[1],&receive_position[5],4);
      
      HAL_GPIO_WritePin(GPIOB,GPIO_PIN_0,GPIO_PIN_SET);
      delay_us(100);
      HAL_SPI_Transmit(&hspi3,(uint8_t*)transmit_position,sizeof(transmit_position),HAL_MAX_DELAY);
      HAL_GPIO_WritePin(GPIOB,GPIO_PIN_0,GPIO_PIN_RESET);

      printf("%s\r\n",transmit_position);
    }
    printf("\033[6A");
    

    /* USER CODE END WHILE */

    /* USER CODE BEGIN 3 */
  }
  /* USER CODE END 3 */
}

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
/* USER CODE BEGIN 4 */
int _write(int file,char *ptr,int len)
{
  if(HAL_UART_Transmit(&huart1,(uint8_t*)ptr,len,HAL_MAX_DELAY)!=HAL_OK)
  {return -1;}
  
  return len;
}
/* USER CODE END 4 */
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
