ElonFreeman/Jaeger_robotic_arm/slave/slave.ioc

Mcu.UserName=STM32F407ZGTx
PA0-WKUP.Signal=UART4_TX
PA1.Signal=UART4_RX
PA10.Signal=USART1_RX
PA13.Signal=SYS_JTMS-SWDIO
PA14.Signal=SYS_JTCK-SWCLK
PA15.Signal=SYS_JTDI
PA9.Signal=USART1_TX
PB0.Signal=GPXTI0
PB3.Signal=SYS_JTDO-SWO
PB7.Signal=GPIO_Output
PB8.Signal=GPIO_Output
PB9.Signal=GPIO_Output
PC10.Signal=SPI3_SCK
PC11.Signal=SPI3_MISO
PC12.Signal=SPI3_MOSI
